MohammedSalem2510/275grams/unoq-app/models/README.md

Models live here **on the board only**: they're gitignored, never committed.

BirdNET v2.4 (CC BY-NC-SA 4.0) goes in `birdnet/`:
- `BirdNET_GLOBAL_6K_V2.4_Labels.txt`
- `BirdNET_GLOBAL_6K_V2.4_Model_FP32.tflite`

App Lab's Python container can only see this app folder, so the model must be here rather than in `~/chirp-test`.
