MohammedSalem2510/275grams/hardware/enclosure/lid.stl

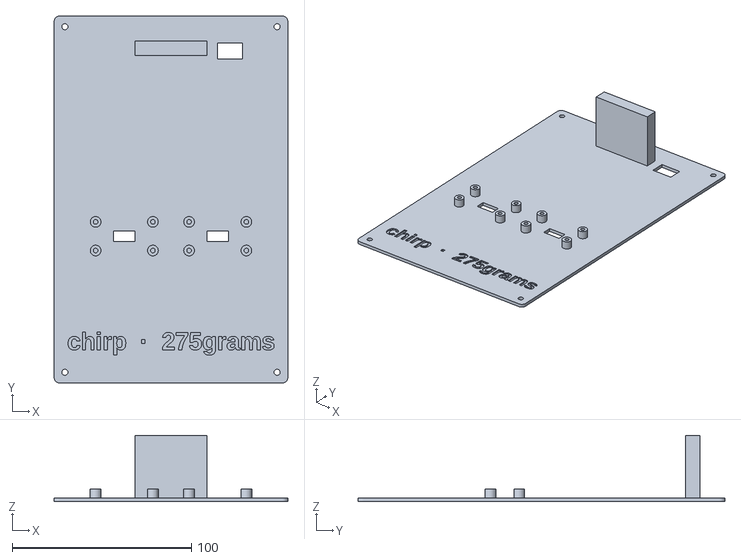
[picture p2: CAD file, 2026-11-14]
hardware/enclosure/lid.stl
130.5 x 205.0 x 37.0
