MohammedSalem2510/275grams/hardware/enclosure/fit_test.stl

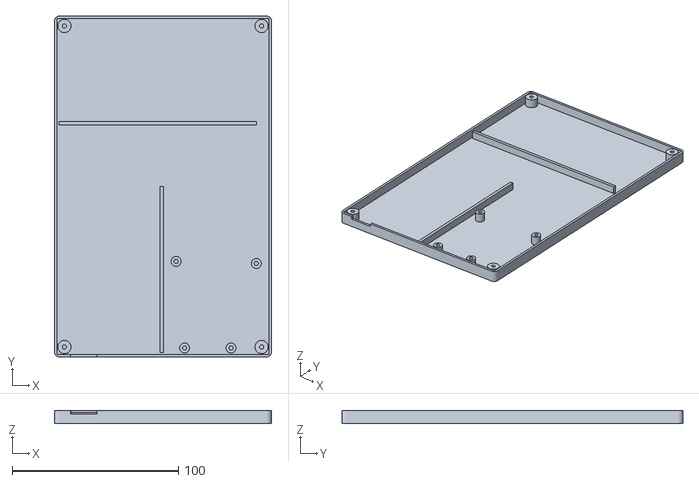
[picture p3: CAD file, 2026-11-14]
hardware/enclosure/fit_test.stl
130.5 x 205.0 x 7.60
