MohammedSalem2510/275grams/hardware/enclosure/base.stl

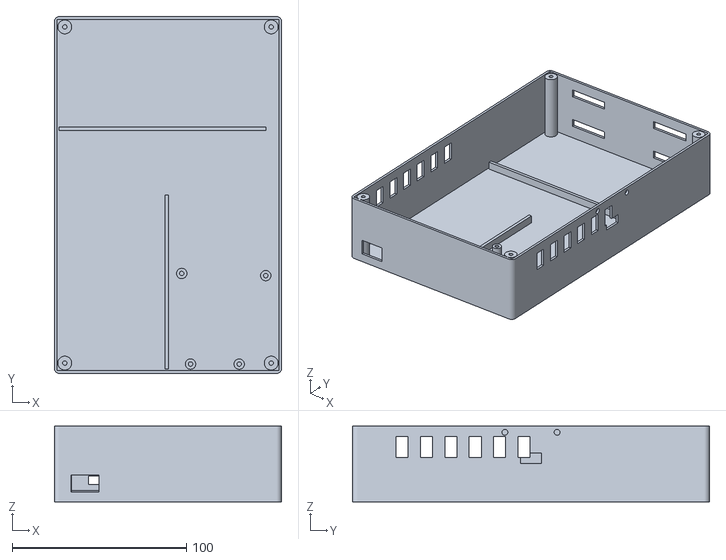
[picture p4: CAD file, 2026-11-14]
hardware/enclosure/base.stl
130.5 x 205.0 x 43.6
