MohammedSalem2510/275grams/hardware/enclosure/shield.stl

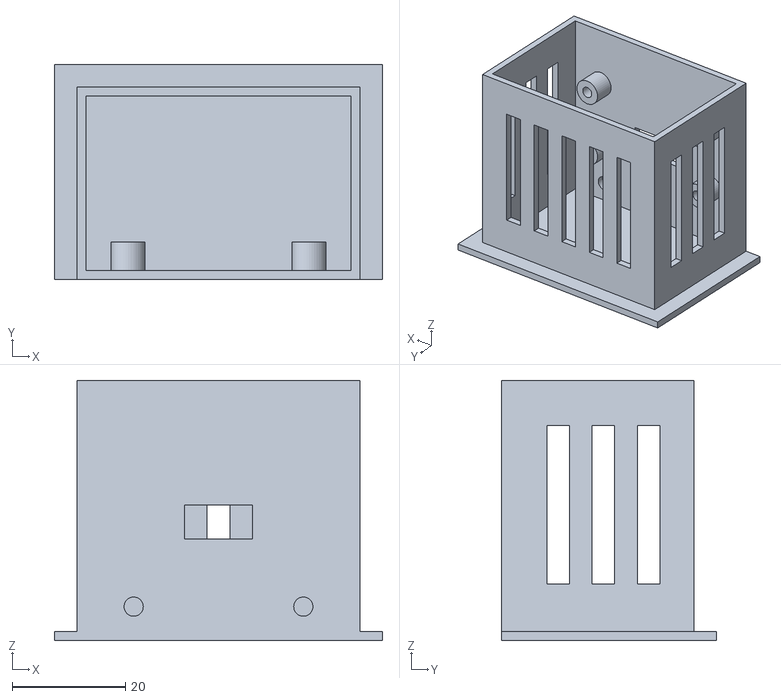
[picture p5: CAD file, 2026-11-14]
hardware/enclosure/shield.stl
58.0 x 38.0 x 46.0
