MohammedSalem2510/275grams/(commit log)

2026-11-13 Scaffold: UNO Q app, ESP32 nodes, MQTT protocol, PR template
    Claude-Session: https://claude.ai/code/session_015qSvBUSoeQE6uxR262ESct
2026-11-13 kws: match verified App Lab APIs, drop MQTT from MVP, add CLAUDE/AGENTS.md
    Brick id is arduino:keyword_spotting; sketch.yaml has no fqbn (as in stock
    examples). main.py runs without a broker. Records the biodiversity-station
    use case and milestones. tools/deploy.sh is the symlink fallback.
    [sketch.ino]
2026-11-13 docs: align CLAUDE/AGENTS.md with Chirp brief (BirdNET, rate rules), update BOM
2026-11-13 docs: switch workflow to committing straight to main; drop PR template
2026-11-13 docs: record BirdNET + camera mic verified on board (from 2b4ebf9)
2026-11-13 kws: run BirdNET inside the App Lab app and signal the MCU over Bridge
    main.py captures the camera mic with arecord, runs bird_audio.predict in a
    background thread, and calls bird_detected on the MCU for accepted windows.
    bird_audio.classify keeps its CLI/listen_gui behaviour (now wraps predict).
    Drops the KWS Brick. NOT TESTED ON HARDWARE YET: unknown whether App Lab's
    runtime can see arecord, the camera device and ai_edge_litert.
2026-11-13 kws: set camera mic gain to 20% at startup (100% default clips)
    Measured on the board: room noise at 100% clipped 22% of samples; 20% peaks
    ~-10 dBFS with no clipping. Gain set live on the board; main.py change NOT
    TESTED in App Lab yet.
2026-11-13 docs: first live BirdNET test on board (chaffinch 0.59/0.72, 0.3 s per window)
2026-11-14 docs: note worst-case test conditions; keep mic gain at 20%
2026-11-14 mcu: list MsgPack's dependency chain in sketch.yaml
2026-11-14 kws: load BirdNET from unoq-app/models/birdnet (container can't see ~/chirp-test)
    App Lab installs requirements.txt in its container; the model must sit inside
    the app folder on the board. Model files are gitignored.
2026-11-14 docs: App Lab deploy facts verified on board (symlink, container, model path, libs)
2026-11-14 docs: demo-v1 tagged; demo-v2 is the current priority
2026-11-14 kws+dashboard: laptop backend (FastAPI/SQLite) and board uploads every window
    protocol/http.md defines the contract. Backend: idempotent window ingest,
    stations/status, species, detections, rates (null = no data). Smoke-tested
    locally with TestClient. Board uploader: batched, retries with same
    window_ids, never blocks inference. Board upload NOT TESTED ON HARDWARE YET.
2026-11-14 docs: board -> laptop upload verified on Junction Wi-Fi
2026-11-14 docs: integrate the Chirp dashboard with the station API
    Replace the backend check page with an interactive map. Show station status, filter by species and time period, colour the heatmap by detections per listening hour, and list recent detections for the selected station. Display the API low listening effort flag alongside the rate.
    Use a coordinate grid when Google Maps is unavailable and document local setup.
    Core interactions verified in Chrome against FastAPI with an isolated test database. JavaScript syntax checked after integrating the low effort flag. Real hardware and Google Maps rendering were not tested.
2026-11-14 docs: backend must bind 0.0.0.0 so the board can upload
2026-11-14 dashboard: seed clearly labelled synthetic week for sim-* stations
    seed_simulated.py writes only to stations marked simulated, tags every window
    model_version=SIMULATED, deletes and regenerates (fixed seed), includes offline
    days and song-bout clusters. kws: add reed bunting and sedge warbler to the
    Finnish list (labels verified on board).
2026-11-14 docs: preserve the standalone Chirp map prototype
    Add the browser-only prototype with sample bird observations, species and period filters, heatmap, themes, and optional Google Maps configuration.
    All 12 model tests pass. This prototype uses sample data and was not tested on real hardware.
2026-11-14 dashboard+kws: early-warning alerts, weekly trends, 12-week seed; winter species
    Backend counts detection-minutes; /api/trends (weekly) and /api/alerts (>=30%
    drop, enough listening both sides, Poisson p<0.01). Seeder plants one decline
    (reed bunting, sim-3); it is the only alert raised. alerts.js adds the panel
    without touching app.js. Winter residents added to the live list (labels not
    yet checked on the board). Backend tested locally; board change NOT TESTED.
2026-11-14 kws: read backend URL from gitignored server_url.txt on the board
    A teammate's local IP edit to main.py blocked git pull on the board; the
    address is per-board config, not code.
2026-11-14 kws: fix two winter species names (verified on board); docs: settings + early warning
2026-11-14 kws: accept all 269 regularly occurring Finnish birds BirdNET knows
    List moves to unoq-app/python/finnish_species.txt (exact labels, verified
    against Labels.txt on the board). Only Steller's eider is absent from BirdNET.
2026-11-14 dashboard: professional 'field instrument' UI (map + side panel)
    New pro.css (loaded after style.css, which is untouched) and pro.js config:
    IBM Plex Sans/Mono, desaturated basemap, single-hue sequential blue scale
    (dataviz palette) with a ticked legend and units, hollow dashed pins for no
    data, hatching for simulated, pulse for live, hard-edged rate rings instead
    of blurred glows, provenance bar (model, metric, UTC, status). index.html
    re-laid out with the same element IDs. app.js: two config hooks only
    (CHIRP_SCALE_MAX, CHIRP_MAP_OPTIONS); behaviour unchanged without pro.js.
    alerts.js mounts in the side panel. Checked in headless Chrome at desktop
    and narrow widths.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
2026-11-14 dashboard: add map views and bird statistics to Field Atlas
    Fit Street and Satellite basemaps and a zoom-based 3D tilt toggle into the existing Filters card. Keep the Field Atlas layout and link a separate page for bird activity, listening effort and trends.
    Checked map controls in the local dashboard. UNO Q hardware was not tested for this dashboard change.
2026-11-14 dashboard: one style (field instrument) on map and statistics; drop 3D tilt
    - statistics.html now uses pro.css, the shared top bar and Map | Statistics
    nav (content and IDs unchanged); retired per-browser theme restore.
    - app.js: back to raster rendering so the muted basemap styles apply again
    (vector maps ignore JSON styles and need a Cloud Map ID); 3D tilt removed,
    Street/Satellite switch kept.
    - pro.css: map-page layout scoped to body.atlas-page; statistics styles on
    the same tokens.
    - concept-map/ marked as a superseded prototype.
    Checked both pages in headless Chrome.
2026-11-14 protocol: optional temperature/duty/clip on windows; temps in trends/alerts; Darwin Core export
2026-11-14 kws+mcu+dashboard: field recording, Modulino context, duty cycle, Darwin Core export
    Board (unoq-app):
    - Field recording (opt-in via python/record_audio flag): one-minute WAVs in
    unoq-app/recordings/ (gitignored); any file where speech was even weakly the
    top label is deleted on close; pauses below 1 GB free. Windows carry clip +
    offset for evidence playback.
    - Sketch: Modulino Thermo (temperature per window), Buzzer (chirp per
    detection), Knob (duty cycle 100/50/25/10 %, press = 100 %, bar on the
    matrix). Each Modulino optional. Compiled on the board (arduino-cli).
    - main.py polls MCU every 10 s; skipped windows are neither analysed nor
    counted as listening, so rates stay correc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
    [sketch.ino]
2026-11-14 hardware: parametric 3D-printed station enclosure (base, lid, Thermo shield)
    OpenSCAD model + STLs. Sizes: UNO Q 68.85x53.34 (15 mm tall, measured),
    Arduino USB-C hub 119x27.8x16 (TPX00241 datasheet), Anker A1259 100x60x25
    (measured), Modulino 41x25.36 with 32x16 holes. Camera clamps onto a lid
    mast; Thermo sits in a louvred radiation shield on the side. Rendered and
    checked: each part is a single solid. UNO hole pattern still to verify
    against the real board before printing.
    [base.stl, chirp_enclosure.scad, lid.stl, shield.stl]
2026-11-14 hardware: fix enclosure fit (lid lip notches, shield joint heights, taller UNO posts) + fit test
    Found in review: lid lip collided with the corner screw posts; shield bolt
    holes clashed with the Thermo posts and sat 2.4 mm off the base holes; UNO Q
    has underside connectors (posts 4 -> 6 mm). Interference checks now pass
    (seated lid vs base empty; bolt heads vs posts empty) and a control check
    shows the old lip does clash. Adds fit_test.stl (floor + posts + rails).
    [base.stl, chirp_enclosure.scad, fit_test.stl, lid.stl, shield.stl]
2026-11-14 hardware: engrave team name 275grams on the enclosure lid
    0.8 mm engraved (prints face-down without supports); team_name, size and
    font are parameters. Lid still seats (interference check empty).
    [chirp_enclosure.scad, lid.stl]
2026-11-14 hardware: lid label 'chirp · 275grams'
    Label measured at 8.6-123.7 mm on the 132 mm lid (8.4 mm margins, clear of
    screw holes); lid still seats (interference check empty).
    [chirp_enclosure.scad, lid.stl]
2026-11-14 hardware: 32 mm plug room in front of the hub; UNO holes match team's ruler check
    Power-bank -> hub USB-C plug had 8 mm (needs ~30). Base now 132x175x47.
    UNO hole pattern 48.3/27.9 mm matches measured ~5 cm / just under 3 cm.
    [base.stl, chirp_enclosure.scad, fit_test.stl, lid.stl, shield.stl]
2026-11-14 hardware: hub_back_room option for ports on the hub's back side
    Hub has ports on both long sides. Default 0 (used ports face forward, base
    132x175); 32 gives plug room behind it too (base 132x207). Both variants
    render as one solid and the lid seats.
    [base.stl, chirp_enclosure.scad]
2026-11-14 hardware: plug room both sides of the hub (USB-A and USB-C PD on opposite sides)
    Base now 132x207x47; all parts single solids, lid seats (checks empty).
    [base.stl, chirp_enclosure.scad, fit_test.stl, lid.stl, shield.stl]
2026-11-14 node: remove Atech ESP32 node firmware (scope cut; mics never verified)
2026-11-14 dashboard: restore Seun's satellite 3D tilt; Street stays raster (muted styles), Satellite renders vector
    Switching view rebuilds the map at the same centre/zoom because the renderer is fixed per map.
    Not tested with a Maps key (none on this laptop); syntax-checked only.
2026-11-14 hardware: thinner walls/floor (1.6 mm) and lid (2 mm) for the lab's 4 h print limit
    Base + lid + shield: 255 -> 177 cm3 of plastic (-30 %). Interior unchanged, so parts still fit.
    Not yet printed.
    [base.stl, chirp_enclosure.scad, fit_test.stl, lid.stl, shield.stl]
2026-11-14 docs: remove superseded prototype, internal handoff brief and stale tools for submission
    concept-map/ was replaced by dashboard/; the brief and tools/ predate the current station (all in history).
2026-11-14 docs: submission README (problem, how it works, honesty rules, measured results, quick start); hardware BOM without Atech; pin backend deps to tested versions
2026-11-14 docs: credit the Lil' Birb sprite used on the LED matrix
2026-11-14 mcu: bird flaps its wings on detection (Lil' Birb flight cycle, 125 ms frames, non-blocking)
2026-11-14 mcu: remove flapping animation from scope (revert ebce5e9); back to the static Lil' Birb glyph
    Matches demo-v3, which is what's verified on the board (buzzer works).
    [sketch.ino]
2026-11-14 hardware: lid prints top-up with no supports (drop locating lip; corner screws locate it)
    Old lid was exported flipped, leaving the mast and bosses under the plate: ~26 000 mm2 of overhang.
    New lid: 0 mm2 overhang (checked on the STL), 64.7 cm3. Not yet printed.
    [chirp_enclosure.scad, lid.stl]
2026-11-14 dashboard: 'Species heard here' cards with cached iNaturalist photos when a station is clicked
    Per species: photo (credit + licence shown), detection-minutes, last heard (Helsinki), best model score,
    latest clip; clicking a card filters to that species. Photos fetched once by the laptop and cached;
    'python -m dashboard.fetch_photos' pre-fetches for offline demos (19/19 current species found).
    Exact scientific-name or synonym match, birds only; reusable licences only. Refreshes no longer cut off a playing clip.
    Endpoints tested on a copy of the live DB; page not visually checked.
2026-11-14 dashboard: station details open as a popup next to the clicked pin (summary + species heard here)
    Sidebar keeps filters, early warnings and recent detections (now labelled with the station).
    Close with x or Esc; follows the pin on Google pan/zoom; bottom sheet under 900 px. Not visually checked.
2026-11-14 protocol: latest temperature_c / temperature_at on /api/stations
2026-11-14 dashboard: air temperature in the station popup; weather tag on alerts; 'Learn more' with polished copy
    Popup: latest Modulino Thermo reading + its age. Alert rows: '4.8 °C colder than before' only when a
    >= 3 °C shift could explain the drop. Rule text rewritten as a short intro, three criteria and a caveat.
    API tested on a copy of the live DB; page not visually checked.
2026-11-14 dashboard: accent is Pantone 13-0116 Pastel Green (#B2D4B2) for fills, deep green #3f6f3f for text/links/focus
    Pastel is 1.6:1 on white, so it is used for fills only; --accent-ink keeps text and focus rings at 5.9:1.
    Legend live/simulated swatches now use the pin colour. Map data ramp unchanged. Not visually checked.
2026-11-14 dashboard: purple activity ramp for pins and legend (green vanished over forest on satellite)
    Scored ramps vs map backgrounds (OKLab dE, worst case): green 1.5, orange 6.9, blue 9.1, magenta 9.3,
    purple 9.9. Interface accent stays pastel green. Not visually checked.
2026-11-14 dashboard: site icon is the Lil' Birb pixel bird (CC0), same as the LED matrix
    favicon.svg (crisp pixels), favicon.ico 16/32/48, apple-touch-icon 180 px on a pastel-green tile.
2026-11-14 dashboard: experiment with activity heatmap and cleaner UI (not hardware tested)
2026-11-14 kws: raise default mic gain to 100% for field use (untested on hardware)
    Indoors 100% clipped 22% of samples on room noise; set CHIRP_MIC_GAIN=20% for demos.
    Claude-Session: https://claude.ai/code/session_015qSvBTdHQQyi7RJC9g1LH7
2026-11-14 kws: outdoor mic gain 80% (100% peaked at -3.5 dBFS on traffic, close birds clipped)
    Measured outdoors on chirp-1 at 100%: background peaks -3.5 dBFS, Goldcrest
    windows at -0.0 dBFS with 1.1% of samples clipped. 80% gives ~3 dB headroom.
    80% itself not yet verified on hardware.
2026-11-14 docs: README for submission: team, AI tools used (MLH), judging criteria, station-hosted backend, six simulated stations, seasonal-filter limitation
2026-11-14 dashboard: every evidence clip uses the green Play recording pill (one clip at a time); map defaults to flat satellite view
    Cache-busting versions bumped so phones load the new app.js, species.js and demo6.css together.
    Smoke-tested on the laptop backend; not yet checked on the board's hotspot.
2026-11-14 dashboard: Railway hosted mode with token-authenticated uploads that stores and plays clips; backfill script for real history
    Based on Ryan Farhat's f831fcf (Dockerfile, /data volume, station token). Changed: the hosted site
    keeps and serves evidence clips (clip PUT needs the token, GET is public), and the container re-seeds
    the labelled simulated stations on start. Tested locally in hosted mode: 401 without/with a wrong
    token, idempotent uploads, 5480 real windows and 52 clips copied, public clip playback.
    Railway build itself not yet tested.
2026-11-14 docs: Railway setup from main, backfilling real history, pointing the station at the public site
2026-11-14 dashboard+kws+docs: revert Railway hosting (back to final, 47fcb05)
    Undoes a73bf4a, 82ea795 and af3b1a1 as asked.
